atelierdbp/35mm_slide_scanner/(notices)

Notices in the files:
slide_scanner_1.2.ino:
This program is free software. It can be redistributed and/or modified under the terms of the GNU General Public License as published by the Free Software Foundation.
